DaryhenViancha/Agricultura-de-precision/Recursos/imagenes_wiki/pcb_elem1.jpeg

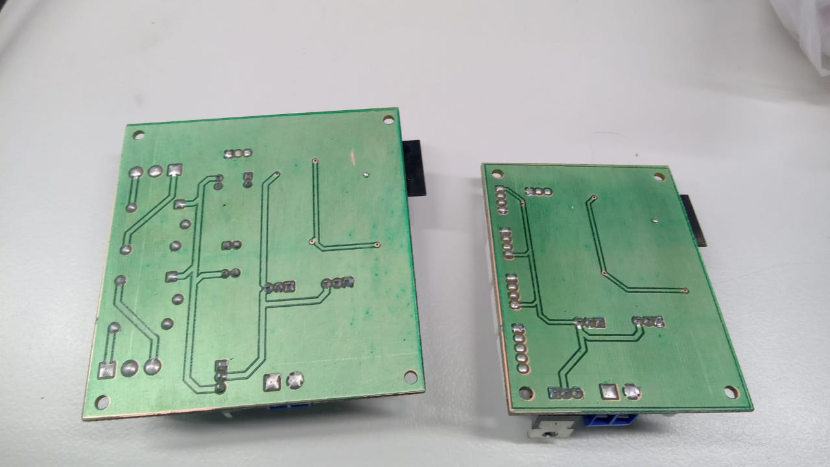
Recursos/imagenes_wiki/pcb_elem1.jpeg
