DaryhenViancha/Agricultura-de-precision/Recursos/imagenes_wiki/pcb_elem3.jpeg

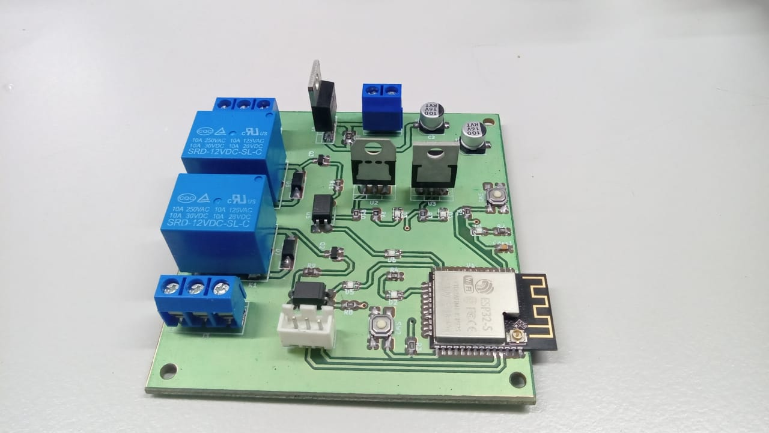
Recursos/imagenes_wiki/pcb_elem3.jpeg
