DaryhenViancha/Agricultura-de-precision/README.md

# Control de Biosistemas
Proyecto de Sistemas Embebidos 2021-2.    
Para la documentación del proyecto revisar la wiki.
