DaryhenViancha/Agricultura-de-precision/Diseño PCB/baterias/tp4056/report.txt

Info: Backing up file "C:\Users\mcsl1\OneDrive - Universidad Nacional de Colombia\Documentos\Universidad\Semestre 11\Embebidos\Control-de-biosistemas\Diseño PCB\baterias\tp4056\sym-lib-table" to file "C:\Users\mcsl1\OneDrive - Universidad Nacional de Colombia\Documentos\Universidad\Semestre 11\Embebidos\Control-de-biosistemas\Diseño PCB\baterias\tp4056\rescue-backup\sym-lib-table-2021-12-15-21-19-03".
Info: Backing up file "C:\Users\mcsl1\OneDrive - Universidad Nacional de Colombia\Documentos\Universidad\Semestre 11\Embebidos\Control-de-biosistemas\Diseño PCB\baterias\tp4056\charger_stepup.sch" to file "C:\Users\mcsl1\OneDrive - Universidad Nacional de Colombia\Documentos\Universidad\Semestre 11\Embebidos\Control-de-biosistemas\Diseño PCB\baterias\tp4056\rescue-backup\charger_stepup-2021-12-15-21-19-03.sch".
Info: Backing up file "C:\Users\mcsl1\OneDrive - Universidad Nacional de Colombia\Documentos\Universidad\Semestre 11\Embebidos\Control-de-biosistemas\Diseño PCB\baterias\tp4056\charger_stepup.pro" to file "C:\Users\mcsl1\OneDrive - Universidad Nacional de Colombia\Documentos\Universidad\Semestre 11\Embebidos\Control-de-biosistemas\Diseño PCB\baterias\tp4056\rescue-backup\charger_stepup-2021-12-15-21-19-03.pro".
Info: Backing up file "C:\Users\mcsl1\OneDrive - Universidad Nacional de Colombia\Documentos\Universidad\Semestre 11\Embebidos\Control-de-biosistemas\Diseño PCB\baterias\tp4056\charger_stepup-cache.lib" to file "C:\Users\mcsl1\OneDrive - Universidad Nacional de Colombia\Documentos\Universidad\Semestre 11\Embebidos\Control-de-biosistemas\Diseño PCB\baterias\tp4056\rescue-backup\charger_stepup-cache-2021-12-15-21-19-03.lib".
Info: Backing up file "C:\Users\mcsl1\OneDrive - Universidad Nacional de Colombia\Documentos\Universidad\Semestre 11\Embebidos\Control-de-biosistemas\Diseño PCB\baterias\tp4056\charger_stepup-rescue.lib" to file "C:\Users\mcsl1\OneDrive - Universidad Nacional de Colombia\Documentos\Universidad\Semestre 11\Embebidos\Control-de-biosistemas\Diseño PCB\baterias\tp4056\rescue-backup\charger_stepup-rescue-2021-12-15-21-19-03.lib".
Info: Backing up file "C:\Users\mcsl1\OneDrive - Universidad Nacional de Colombia\Documentos\Universidad\Semestre 11\Embebidos\Control-de-biosistemas\Diseño PCB\baterias\tp4056\charger_stepup-rescue.dcm" to file "C:\Users\mcsl1\OneDrive - Universidad Nacional de Colombia\Documentos\Universidad\Semestre 11\Embebidos\Control-de-biosistemas\Diseño PCB\baterias\tp4056\rescue-backup\charger_stepup-rescue-2021-12-15-21-19-03.dcm".
Info: Adding library "charger_stepup-rescue", file "${KIPRJMOD}/charger_stepup-rescue.lib" to project symbol library table.
Symbol "R" mapped to symbol library "charger_stepup-rescue".
Symbol "C" mapped to symbol library "charger_stepup-rescue".
Symbol "LED" mapped to symbol library "charger_stepup-rescue".
Symbol "R" mapped to symbol library "charger_stepup-rescue".
Symbol "LED" mapped to symbol library "charger_stepup-rescue".
Symbol "R" mapped to symbol library "charger_stepup-rescue".
Symbol "R" mapped to symbol library "charger_stepup-rescue".
Symbol "C" mapped to symbol library "charger_stepup-rescue".
Symbol "R" mapped to symbol library "charger_stepup-rescue".
Symbol "DW01" mapped to symbol library "charger_stepup-rescue".
Symbol "TP4056" mapped to symbol library "charger_stepup-rescue".
Symbol "CONN_01X01" mapped to symbol library "charger_stepup-rescue".
Symbol "CONN_01X01" mapped to symbol library "charger_stepup-rescue".
Symbol "CONN_01X01" mapped to symbol library "charger_stepup-rescue".
Symbol "CONN_01X01" mapped to symbol library "charger_stepup-rescue".
Symbol "CONN_01X01" mapped to symbol library "charger_stepup-rescue".
Symbol "CONN_01X01" mapped to symbol library "charger_stepup-rescue".
Symbol "C" mapped to symbol library "charger_stepup-rescue".
Symbol "FS8205A" mapped to symbol library "charger_stepup-rescue".
Info: Symbol library table mapping complete!
