DaryhenViancha/Agricultura-de-precision/diagramas/agricultura_precision.png

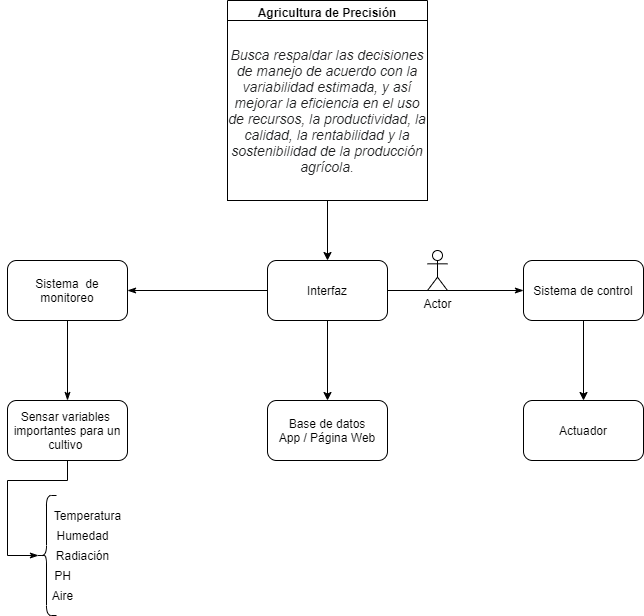
diagramas/agricultura_precision.png
