DaryhenViancha/Agricultura-de-precision/diagramas/arquitectura_biosistemas.drawio.png

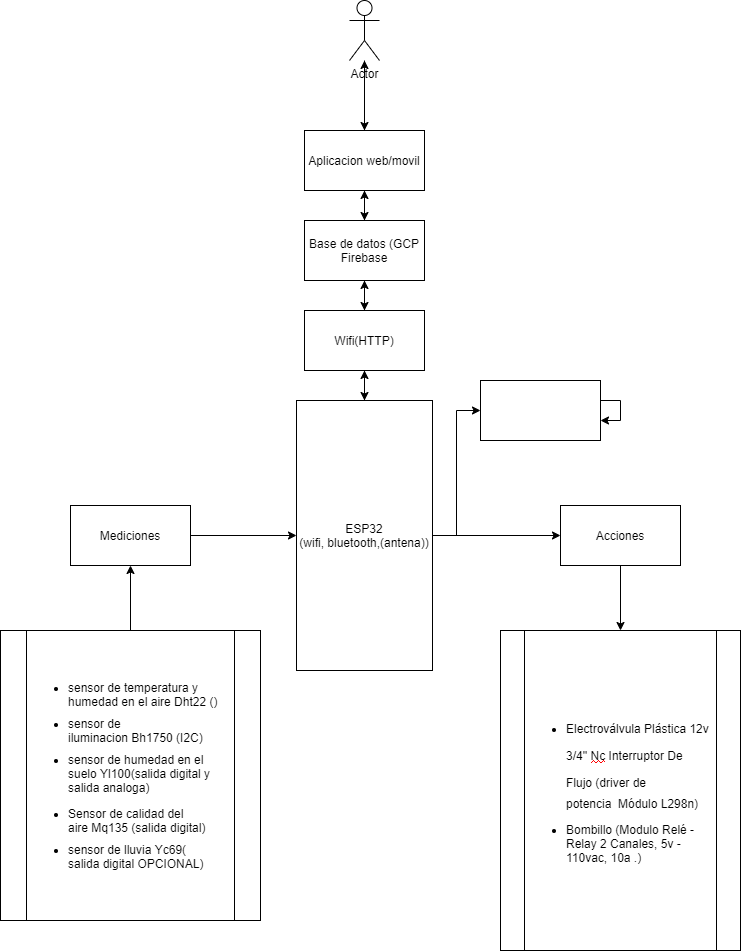
diagramas/arquitectura_biosistemas.drawio.png
