DaryhenViancha/Agricultura-de-precision/diagramas/flujo_proceso_datos.png

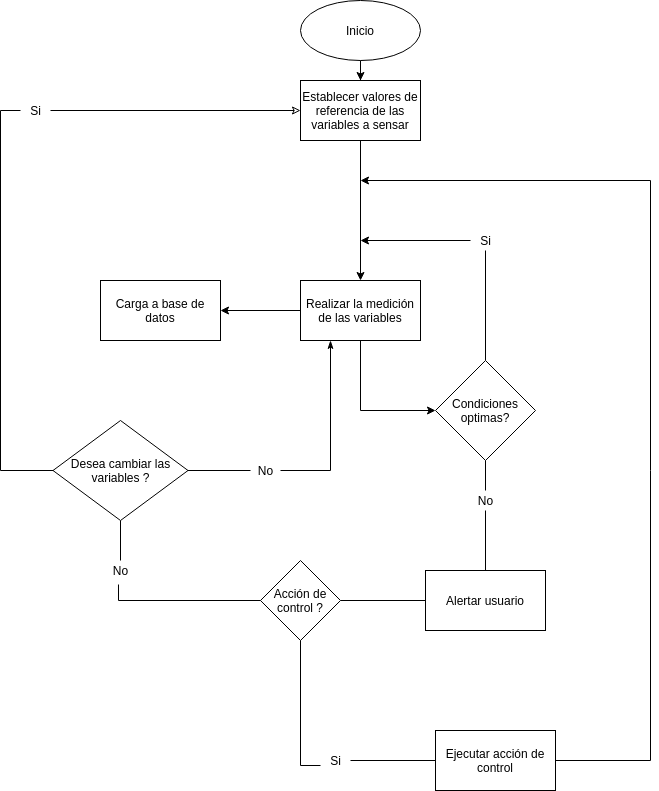
diagramas/flujo_proceso_datos.png
