DaryhenViancha/Agricultura-de-precision/diagramas/flujo_proceso_general.png

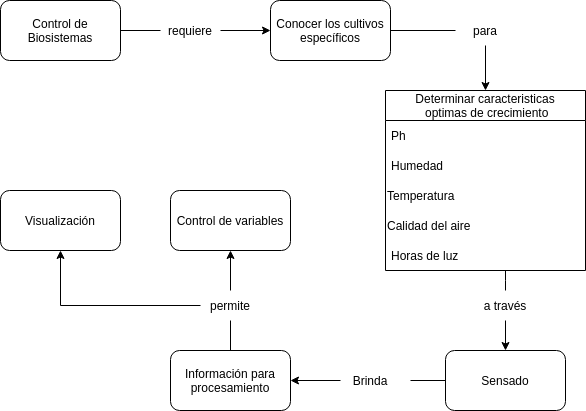
diagramas/flujo_proceso_general.png
