DaryhenViancha/Agricultura-de-precision/diagramas/mockup.png

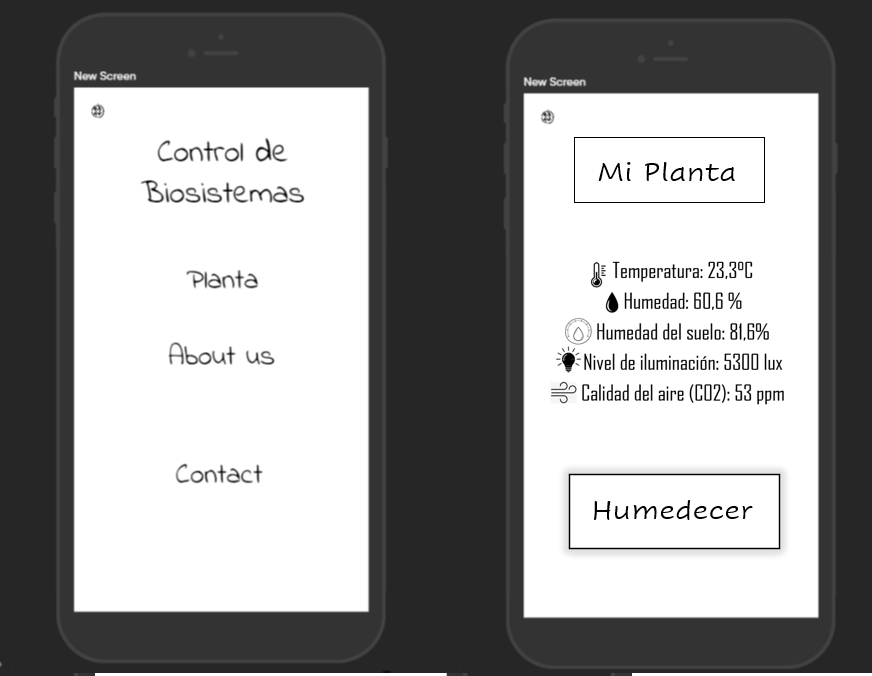
diagramas/mockup.png
