DaryhenViancha/Agricultura-de-precision/Recursos/gitpush.png

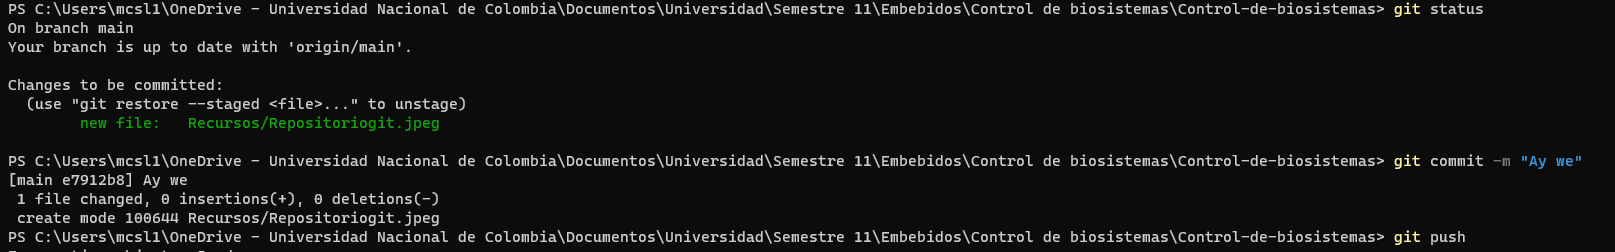
Recursos/gitpush.png
