DaryhenViancha/Agricultura-de-precision/Recursos/imagenes_wiki/esq_gnral.png

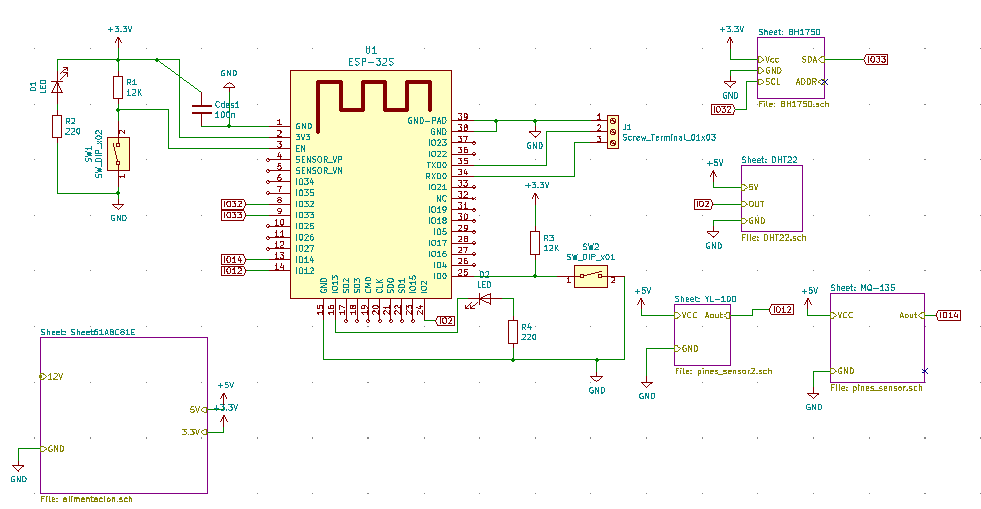
Recursos/imagenes_wiki/esq_gnral.png
