DaryhenViancha/Agricultura-de-precision/Recursos/imagenes_wiki/esq_gnral_reles.png

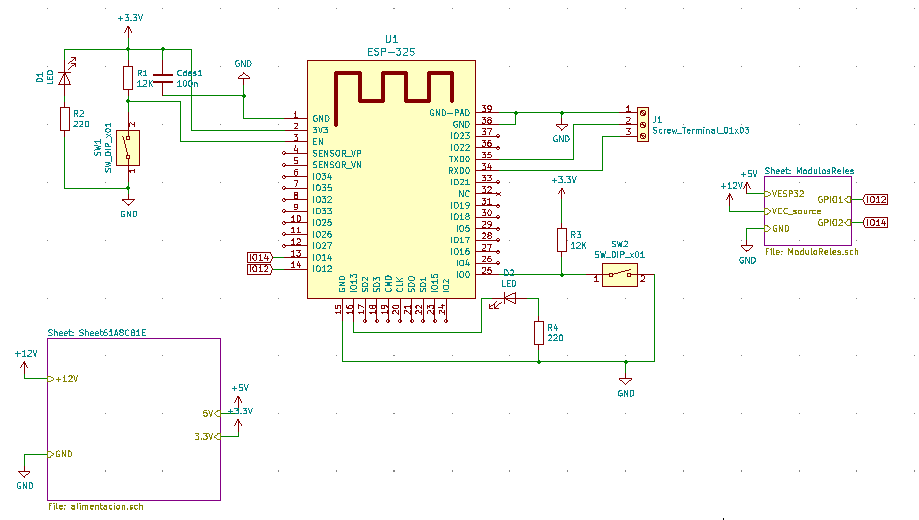
Recursos/imagenes_wiki/esq_gnral_reles.png
