DaryhenViancha/Agricultura-de-precision/Recursos/imagenes_wiki/pcb-elab1.jpeg

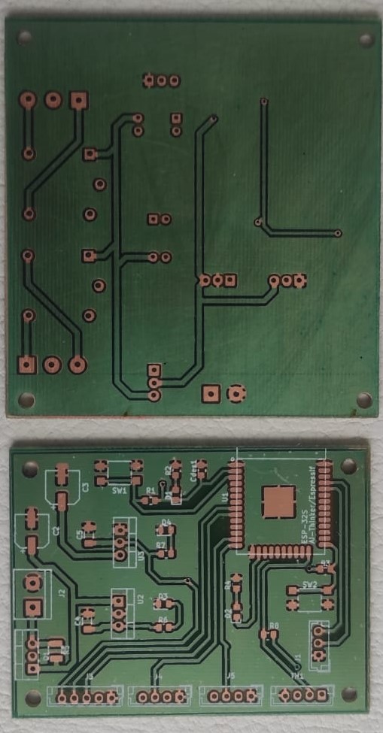
Recursos/imagenes_wiki/pcb-elab1.jpeg
