DaryhenViancha/Agricultura-de-precision/Recursos/imagenes_wiki/pcb-elab2.jpeg

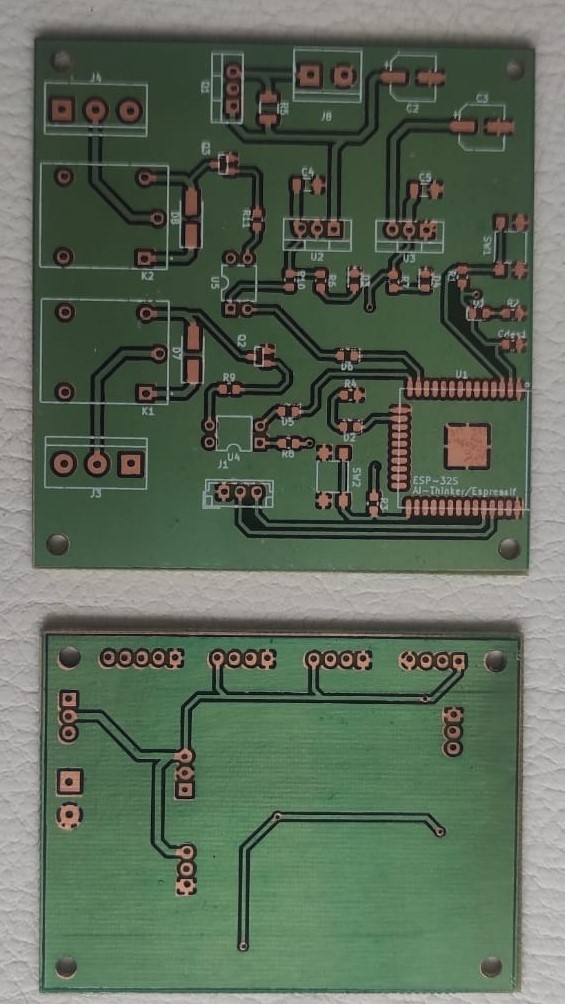
Recursos/imagenes_wiki/pcb-elab2.jpeg
