DaryhenViancha/Agricultura-de-precision/Recursos/imagenes_wiki/PCB-ESP32S.png

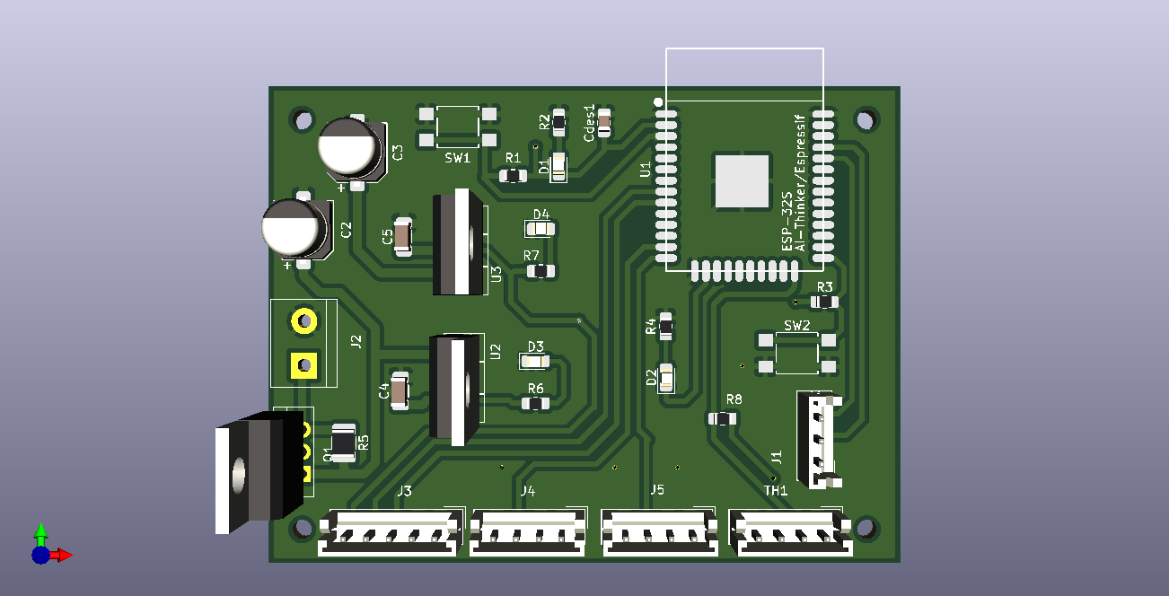
Recursos/imagenes_wiki/PCB-ESP32S.png
