DaryhenViancha/Agricultura-de-precision/Recursos/imagenes_wiki/PCB-ESP32S_2.png

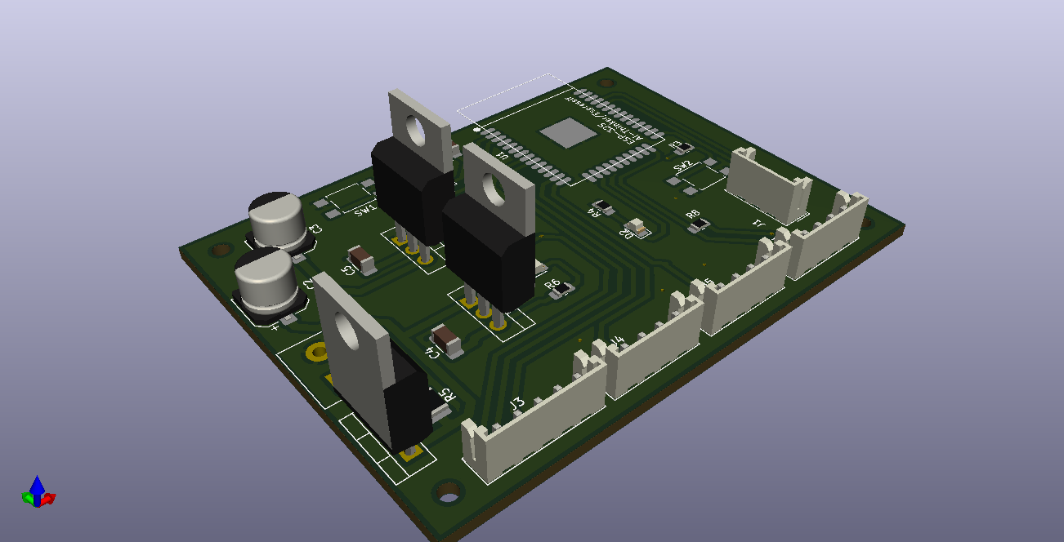
Recursos/imagenes_wiki/PCB-ESP32S_2.png
