DaryhenViancha/Agricultura-de-precision/Recursos/imagenes_wiki/PCB-ESP32S_reles.png

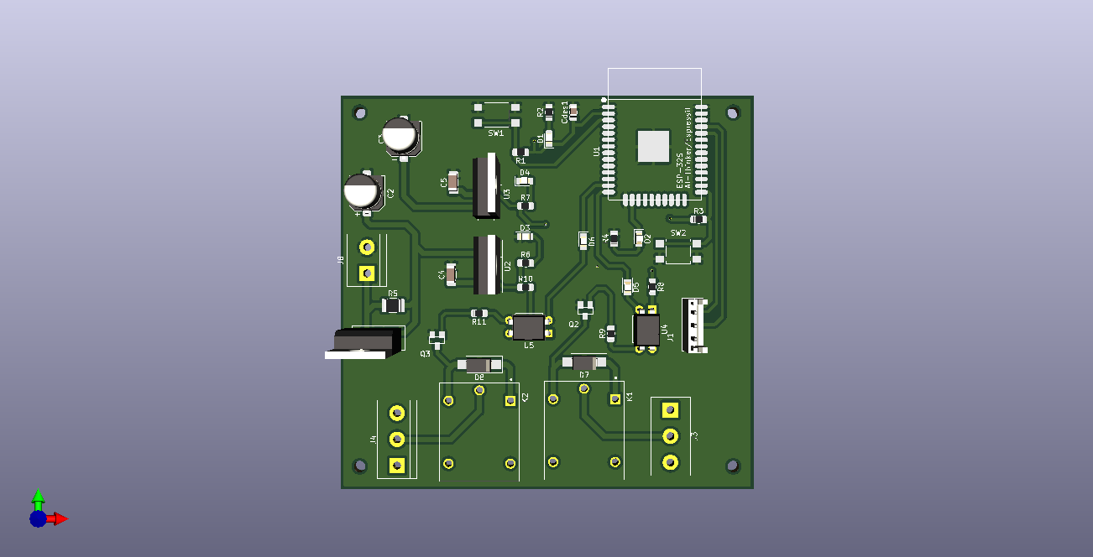
Recursos/imagenes_wiki/PCB-ESP32S_reles.png
