DaryhenViancha/Agricultura-de-precision/Recursos/imagenes_wiki/pcb_elem2.jpeg

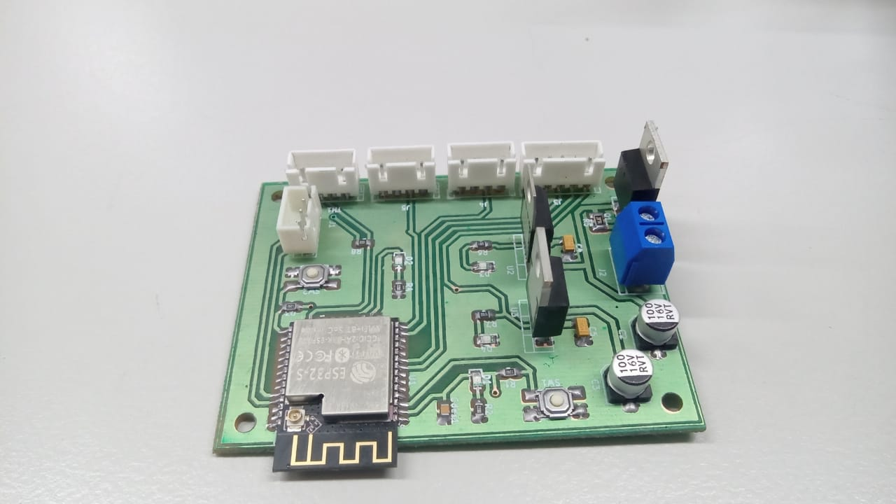
Recursos/imagenes_wiki/pcb_elem2.jpeg
