DaryhenViancha/Agricultura-de-precision/Recursos/Repositoriogit.jpeg

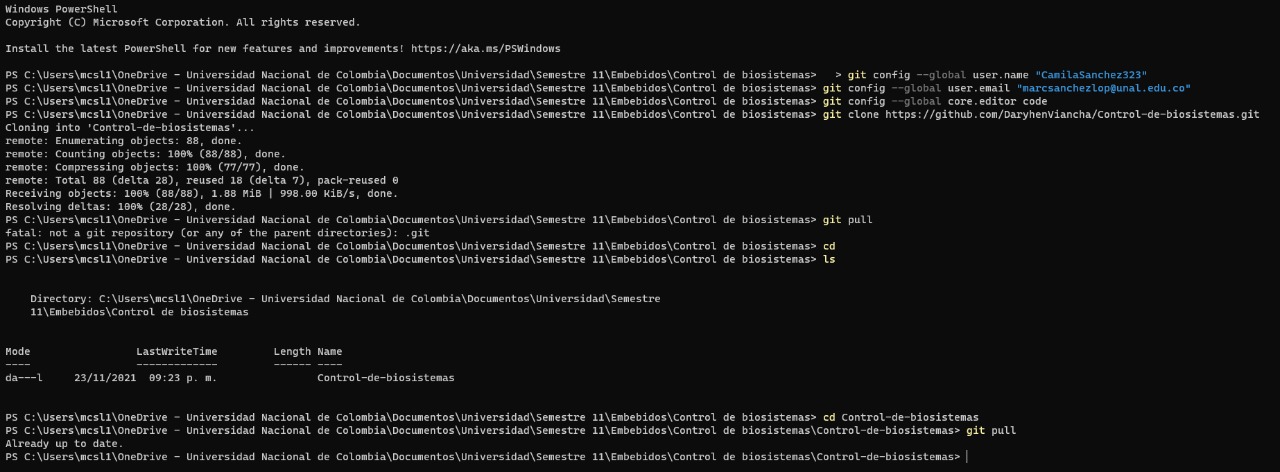
Recursos/Repositoriogit.jpeg
