DaryhenViancha/Agricultura-de-precision/Simulaciones/Etapa_Potencia/Imagenes/Etapa_pot.jpeg

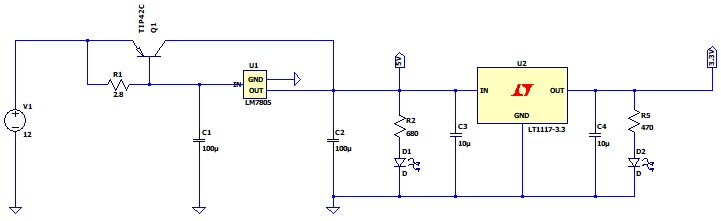
Simulaciones/Etapa_Potencia/Imagenes/Etapa_pot.jpeg
