DaryhenViancha/Agricultura-de-precision/Simulaciones/Etapa_Potencia/Imagenes/Etapa_pot_baja_impedancia_2.jpeg

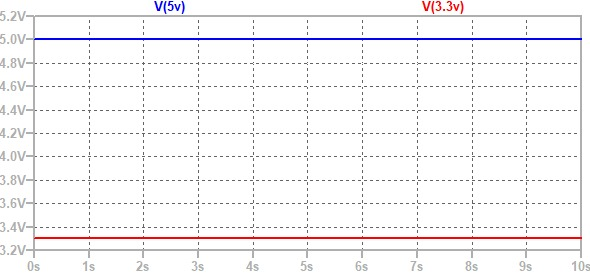
Simulaciones/Etapa_Potencia/Imagenes/Etapa_pot_baja_impedancia_2.jpeg
