DaryhenViancha/Agricultura-de-precision/Simulaciones/Etapa_Potencia/Imagenes/Etapa_pot_baja_impedancia_med.jpeg

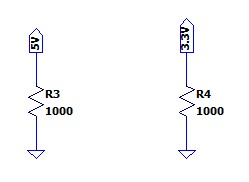
Simulaciones/Etapa_Potencia/Imagenes/Etapa_pot_baja_impedancia_med.jpeg
