DaryhenViancha/Agricultura-de-precision/Simulaciones/Etapa_Potencia/Imagenes/Etapa_pot_Vacio.jpeg

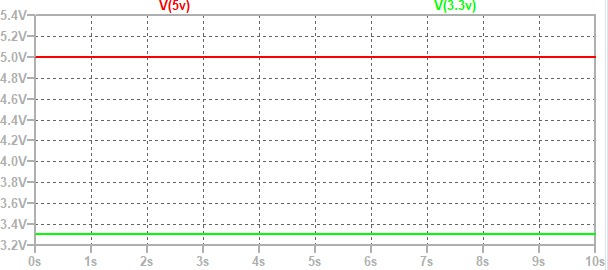
Simulaciones/Etapa_Potencia/Imagenes/Etapa_pot_Vacio.jpeg
