DaryhenViancha/Agricultura-de-precision/Recursos/imagenes_wiki/prueba_prog.jpeg

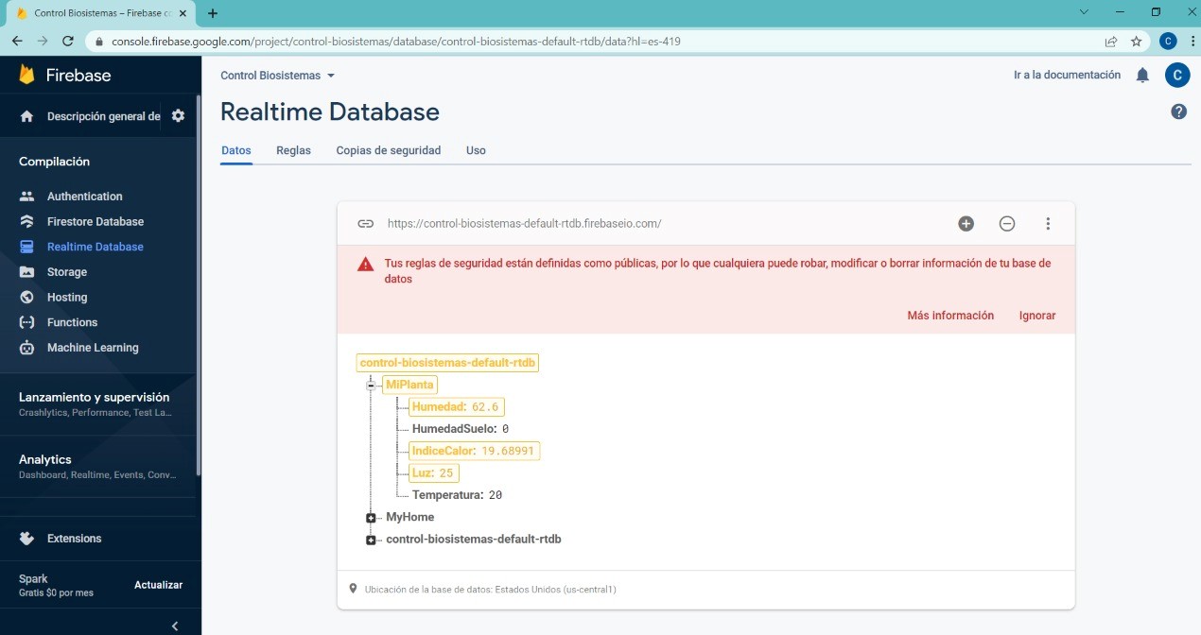
Recursos/imagenes_wiki/prueba_prog.jpeg
