DaryhenViancha/Agricultura-de-precision/Diseño PCB/PCB-ESP32S - reles/PCB-ESP32S.kicad_pcb

## KiCad design Diseño PCB/PCB-ESP32S - reles/PCB-ESP32S.kicad_pcb (2022-01-20)

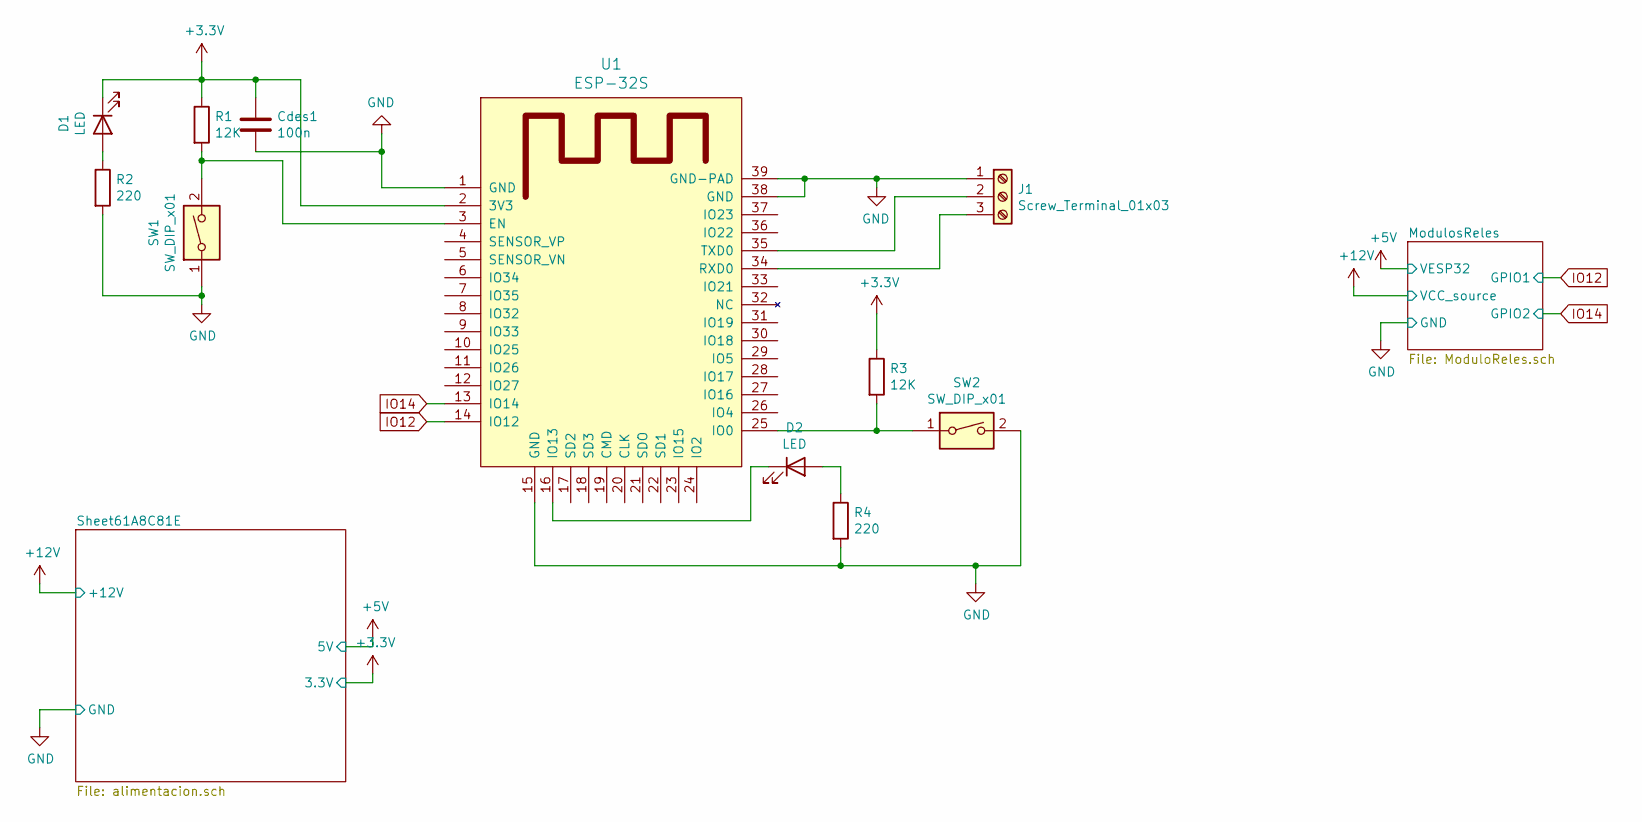
[picture p25: schematic PCB-ESP32S.sch]

Parts:
Cdes1: 100n; C_0805_2012Metric_Pad1.18x1.45mm_HandSolder
D1, D2: LED; LED_0805_2012Metric_Pad1.15x1.40mm_HandSolder
J1: Screw_Terminal_01x03; JST_EH_B3B-EH-A_1x03_P2.50mm_Vertical
R1, R3: 12K; R_0805_2012Metric_Pad1.20x1.40mm_HandSolder
R2, R4: 220; R_0805_2012Metric_Pad1.20x1.40mm_HandSolder
SW1, SW2: SW_DIP_x01; SW_SPST_TL3305A
U1: ESP-32S

Connections:
+3V3: Cdes1.1, D1.1 (K), R1.1, R3.1, U1.2 (3V3); also elsewhere on the board
GND: Cdes1.2, J1.1, R2.2, R4.2, SW1.1, SW2.2, U1.1 (GND), U1.15 (GND), U1.38 (GND), U1.39 (GND-PAD); also elsewhere on the board
IO12: U1.14 (IO12); also elsewhere on the board
IO14: U1.13 (IO14); also elsewhere on the board
unnamed: D1.2 (A), R2.1
unnamed: D2.1 (K), U1.16 (IO13)
unnamed: D2.2 (A), R4.1
unnamed: J1.2, U1.35 (TXD0)
unnamed: J1.3, U1.34 (RXD0)
unnamed: R1.2, SW1.2, U1.3 (EN)
unnamed: R3.2, SW2.1, U1.25 (IO0)

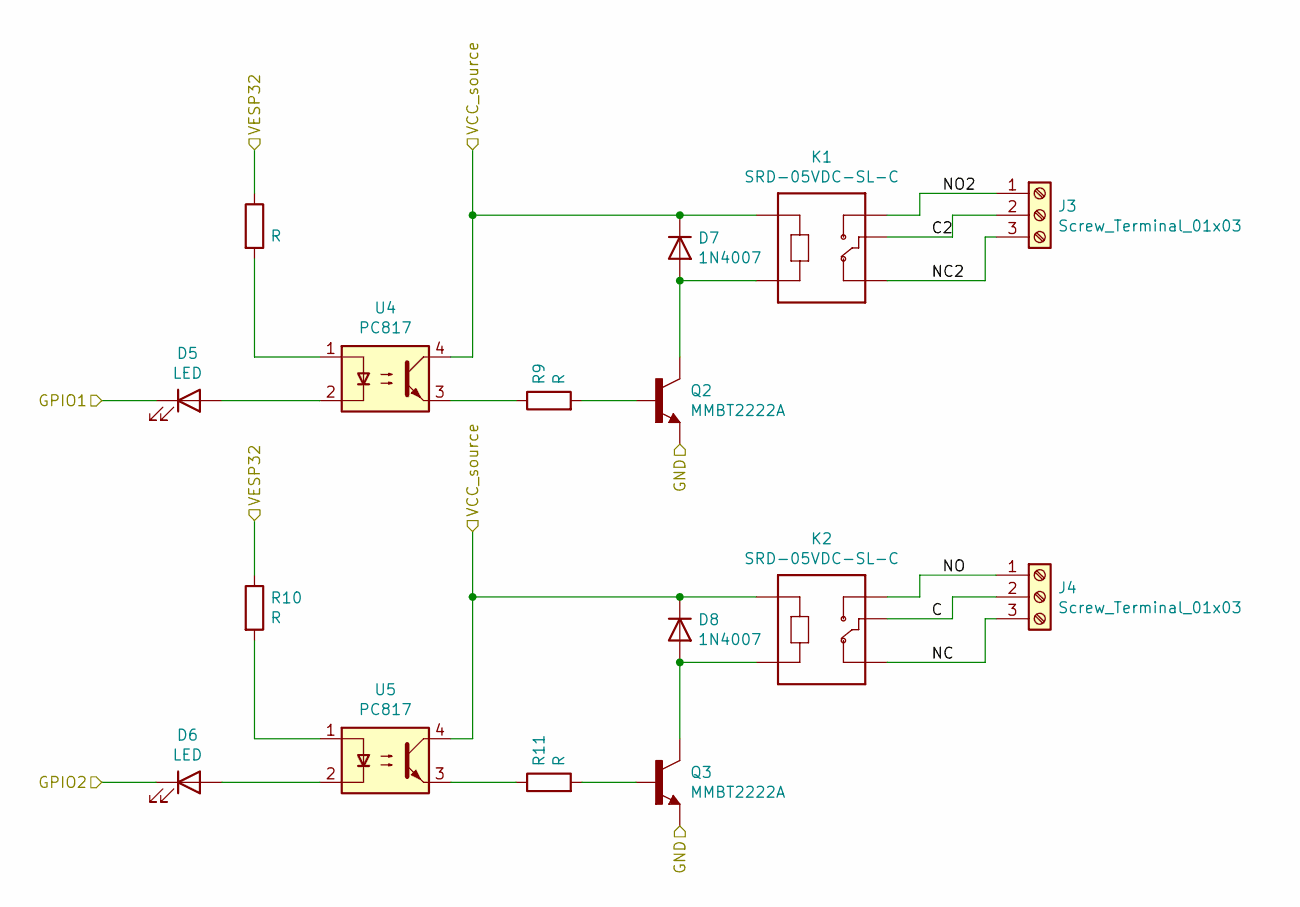
[picture p26: schematic ModuloReles.sch]

Parts:
D5, D6: LED; LED_0805_2012Metric_Pad1.15x1.40mm_HandSolder
D7, D8: 1N4007; D_SMA_Handsoldering
J3, J4: Screw_Terminal_01x03; TerminalBlock_bornier-3_P5.08mm
K1, K2: SRD-05VDC-SL-C; RELAY_SRD-05VDC-SL-C
Q2, Q3: MMBT2222A; SOT23; DIGIKEY 568-4509-6-ND
R8, R9, R10, R11: R; R_0805_2012Metric_Pad1.20x1.40mm_HandSolder
U4, U5: PC817; DIP-4_W7.62mm

Connections:
+5V: R8.1, R10.1; also elsewhere on the board
+12V: D7.1 (K), D8.1 (K), K1.A1, K2.A1, U4.4, U5.4; also elsewhere on the board
/ModulosReles/C: J4.2, K2.COM
/ModulosReles/C2: J3.2, K1.COM
/ModulosReles/NC: J4.3, K2.NC
/ModulosReles/NC2: J3.3, K1.NC
/ModulosReles/NO: J4.1, K2.NO
/ModulosReles/NO2: J3.1, K1.NO
GND: Q2.2, Q3.2; also elsewhere on the board
IO12: D5.1 (K); also elsewhere on the board
IO14: D6.1 (K); also elsewhere on the board
unnamed: D5.2 (A), U4.2
unnamed: D6.2 (A), U5.2
unnamed: D7.2 (A), K1.A2, Q2.3
unnamed: D8.2 (A), K2.A2, Q3.3
unnamed: Q2.1, R9.2
unnamed: Q3.1, R11.2
unnamed: R8.2, U4.1
unnamed: R9.1, U4.3
unnamed: R10.2, U5.1
unnamed: R11.1, U5.3

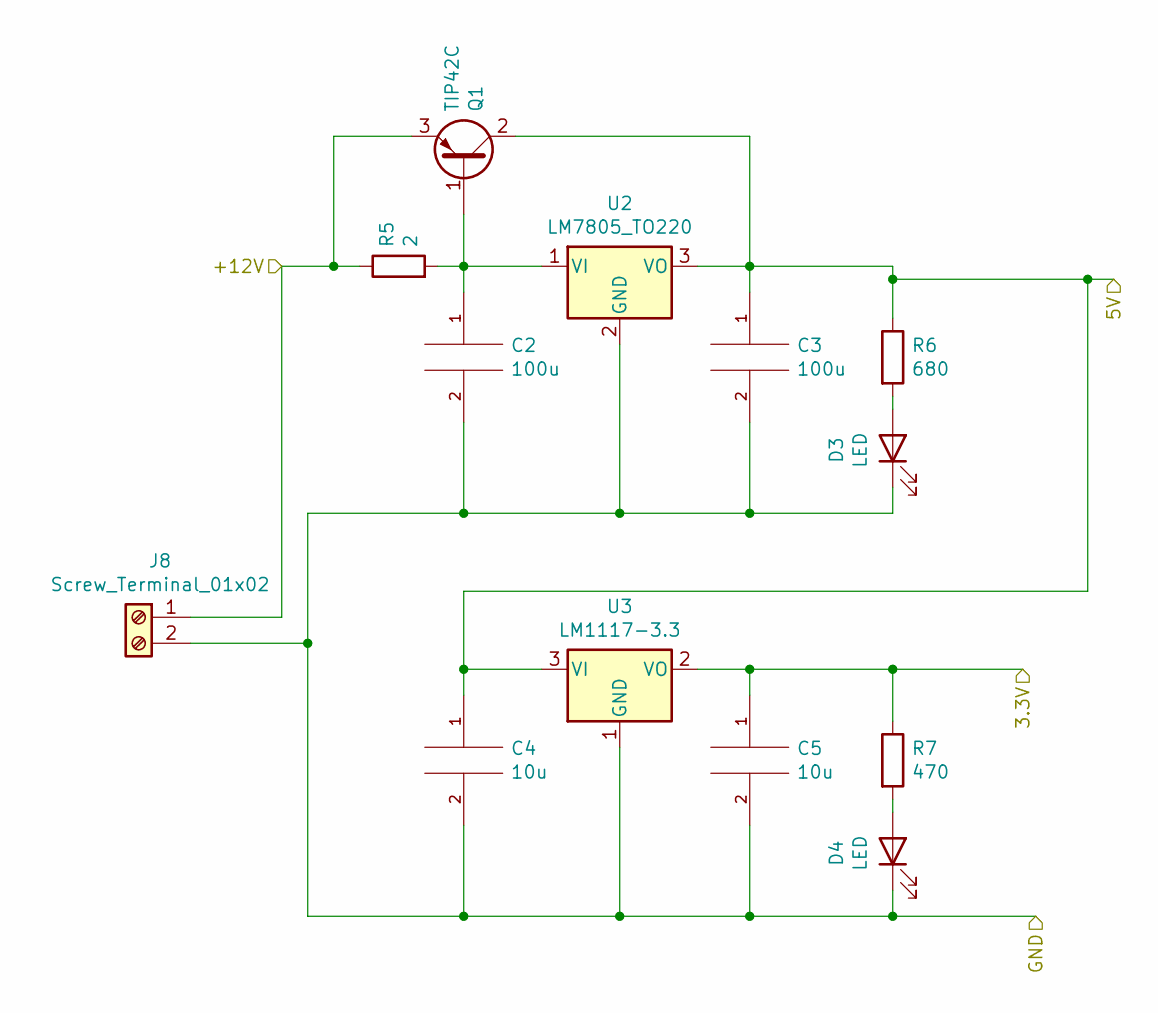
[picture p27: schematic alimentacion.sch]

Parts:
C2, C3: 100u; CP_Elec_6.3x5.8
C4, C5: 10u; C_1206_3216Metric_Pad1.33x1.80mm_HandSolder
D3, D4: LED; LED_0805_2012Metric_Pad1.15x1.40mm_HandSolder
J8: Screw_Terminal_01x02; TerminalBlock_bornier-2_P5.08mm
Q1: TIP42C; TO-220-3_Vertical
R5: 2; R_1210_3225Metric_Pad1.30x2.65mm_HandSolder
R6: 680; R_0805_2012Metric_Pad1.20x1.40mm_HandSolder
R7: 470; R_0805_2012Metric_Pad1.20x1.40mm_HandSolder
U2: LM7805_TO220; TO-220-3_Vertical
U3: LM1117-3.3; TO-220-3_Vertical

Connections:
+3V3: C5.1, R7.1, U3.2 (VO); also elsewhere on the board
+5V: C3.1, C4.1, Q1.2 (C), R6.1, U2.3 (VO), U3.3 (VI); also elsewhere on the board
+12V: J8.1, Q1.3 (E), R5.1; also elsewhere on the board
GND: C2.2, C3.2, C4.2, C5.2, D3.1 (K), D4.1 (K), J8.2, U2.2 (GND), U3.1 (GND); also elsewhere on the board
unnamed: C2.1, Q1.1 (B), R5.2, U2.1 (VI)
unnamed: D3.2 (A), R6.2
unnamed: D4.2 (A), R7.2

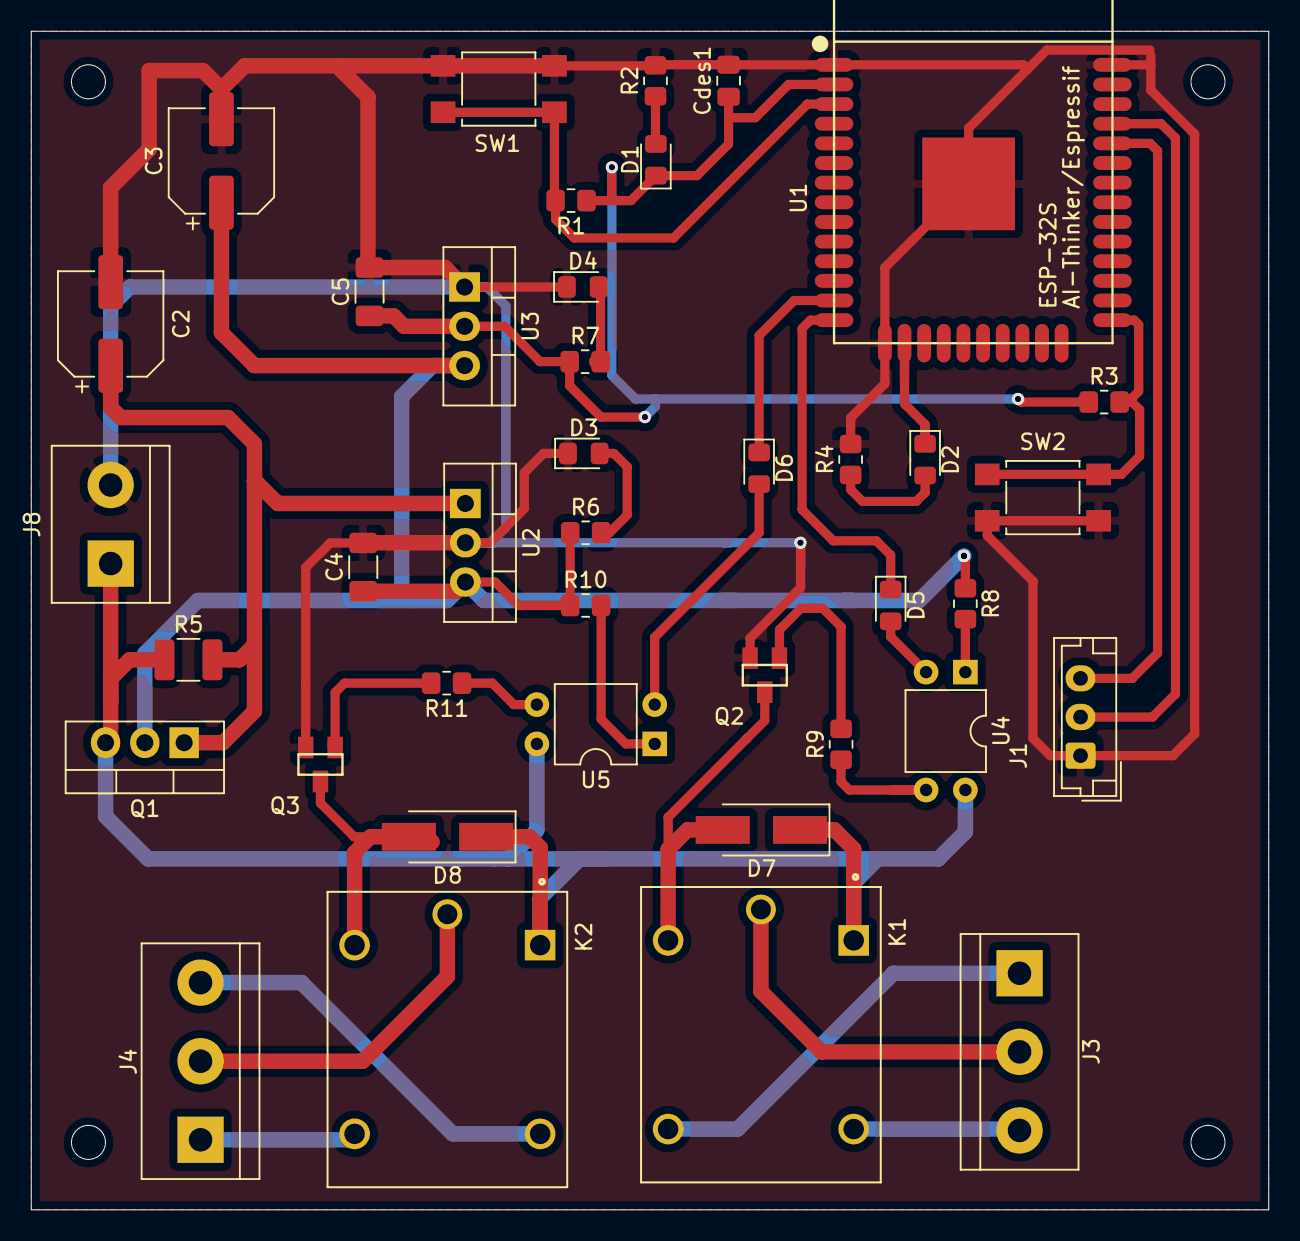
[picture p28: board Diseño PCB/PCB-ESP32S - reles/PCB-ESP32S.kicad_pcb from above]

Board: 2 copper layers, 80.0 x 76.2 mm, 40 parts (0 on the bottom side), 32 nets.
