DaryhenViancha/Agricultura-de-precision/Diseño PCB/PCB-ESP32S - Baterias-incompleto/PCB-ESP32S.kicad_pcb

## KiCad design Diseño PCB/PCB-ESP32S - Baterias-incompleto/PCB-ESP32S.kicad_pcb (2021-12-19)

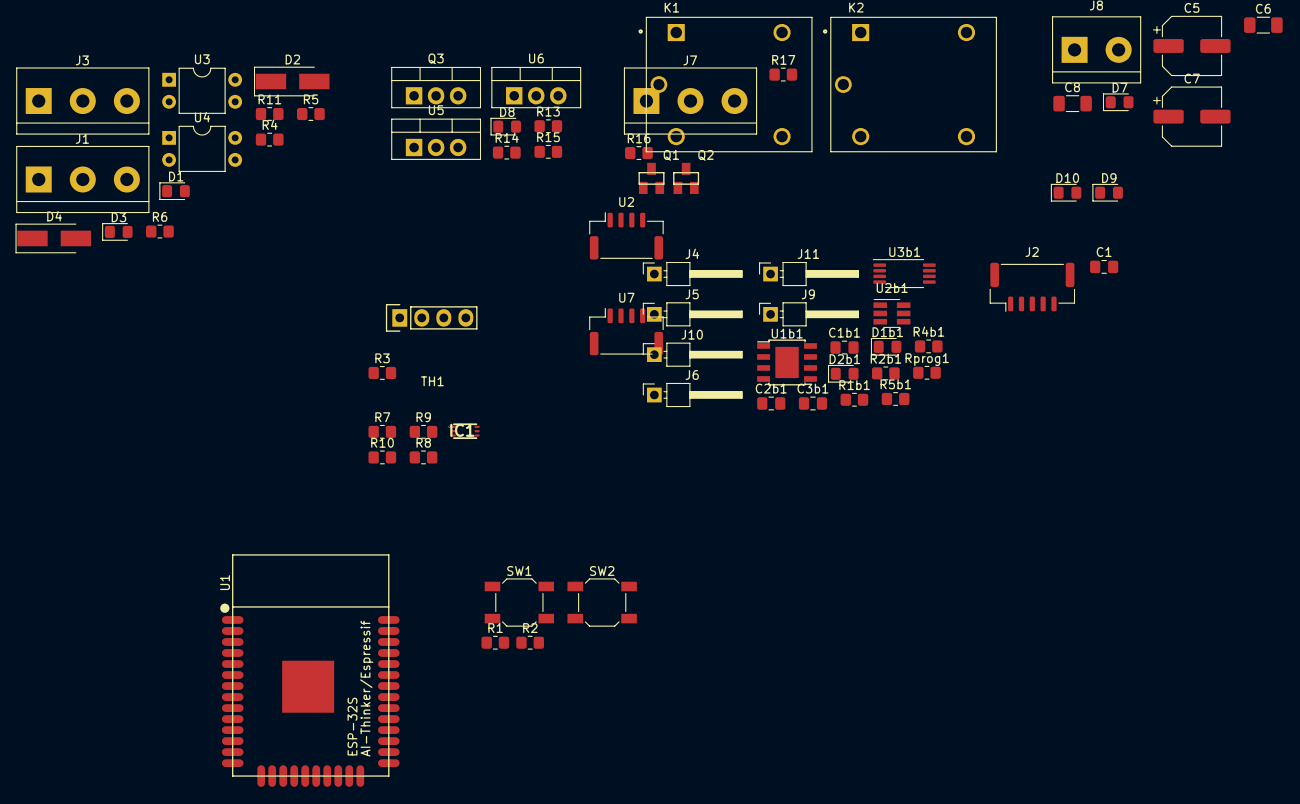
[picture p29: board Diseño PCB/PCB-ESP32S - Baterias-incompleto/PCB-ESP32S.kicad_pcb from above]

Board: 2 copper layers, 69 parts (0 on the bottom side), 50 nets, no tracks yet.

Parts:
C1, C1b1, C3b1: 0.1uF; C_0805_2012Metric_Pad1.18x1.45mm_HandSolder
C2b1: 10uF; C_0805_2012Metric_Pad1.18x1.45mm_HandSolder
C5, C7: 100u; CP_Elec_6.3x5.8
C6, C8: 10u; C_1206_3216Metric_Pad1.33x1.80mm_HandSolder
D1, D1b1, D2b1, D3, D7, D8, D9, D10: LED; LED_0805_2012Metric_Pad1.15x1.40mm_HandSolder
D2, D4: 1N4007; D_SMA_Handsoldering
IC1: BH1750FVI-TR; WSOF6
J1, J3, J7: Screw_Terminal_01x03; TerminalBlock_bornier-3_P5.08mm
J2: Screw_Terminal_01x05; JST_GH_BM05B-GHS-TBT_1x05-1MP_P1.25mm_Vertical
J4: CONN_bat+; PinHeader_1x01_P2.54mm_Horizontal
J5: CONN_bat-; PinHeader_1x01_P2.54mm_Horizontal
J6: CONN_out-; PinHeader_1x01_P2.54mm_Horizontal
J8: Screw_Terminal_01x02; TerminalBlock_bornier-2_P5.08mm
J9: CONN_out+; PinHeader_1x01_P2.54mm_Horizontal
J10: CONN_in+; PinHeader_1x01_P2.54mm_Horizontal
J11: CONN_in-; PinHeader_1x01_P2.54mm_Horizontal
K1, K2: SRD-05VDC-SL-C; RELAY_SRD-05VDC-SL-C
Q1, Q2: MMBT2222A; SOT23
Q3: TIP42C; TO-220-3_Vertical
R1, R2: 12K; R_0805_2012Metric_Pad1.20x1.40mm_HandSolder
R1b1, R2b1, R3, R4b1, R7: 1k; R_0805_2012Metric_Pad1.20x1.40mm_HandSolder
R4, R5, R6, R11: R; R_0805_2012Metric_Pad1.20x1.40mm_HandSolder
R5b1: 100; R_0805_2012Metric_Pad1.20x1.40mm_HandSolder
R8, R9, R10: 4.7k; R_0805_2012Metric_Pad1.20x1.40mm_HandSolder
R13: 2; R_0805_2012Metric_Pad1.20x1.40mm_HandSolder
R14: 680; R_0805_2012Metric_Pad1.20x1.40mm_HandSolder
R15: 470; R_0805_2012Metric_Pad1.20x1.40mm_HandSolder
R16, R17: 220; R_0805_2012Metric_Pad1.20x1.40mm_HandSolder
Rprog1: 10k; R_0805_2012Metric_Pad1.20x1.40mm_HandSolder
SW1, SW2: SW_DIP_x01; SW_SPST_SKQG_WithStem
TH1: DHT22_Temperature_Humidity
U1: ESP-32S
U1b1: TP4056; TP4056_SOP-8-PP
U2, U7: pines_sensor; JST_GH_SM04B-GHS-TB_1x04-1MP_P1.25mm_Horizontal
U2b1: DW01; SOT-23-6_Handsoldering
U3, U4: PC817; DIP-4_W7.62mm
U3b1: FS8205A; TSSOP-8_4.4x3mm_P0.65mm
U5: LM7805_TO220; TO-220-3_Vertical
U6: LM1117-3.3; TO-220-3_Vertical

Connections:
+3V3: D9.1, IC1.1, J2.1, R1.1, R2.1, R7.2, R9.1, R10.1, U1.2
+5V: R3.1, TH1.1
/BH1750/ADDR: IC1.2, J2.5, R8.1
/BH1750/SCL: IC1.6, J2.3, R10.2
/BH1750/SDA: IC1.4, J2.4, R9.2
/ModulosReles/C: J1.2, J3.2, K1.COM, K2.COM
/ModulosReles/GND: Q1.2, Q2.2
/ModulosReles/NC: J1.3, J3.3, K1.NC, K2.NC
/ModulosReles/NO: J1.1, J3.1, K1.NO, K2.NO
/ModulosReles/VCC_source: D2.1, D4.1, K1.A1, K2.A1, U3.4, U4.4
/Sheet61A8C81E/3.3V: C8.1, R15.1, U6.2
/Sheet61A8C81E/5V: C7.1, Q3.2, R14.1, U5.3
/Sheet61A8C81E/12v: C6.1, J8.1, Q3.3, R13.1, U6.3
/Sheet61A8C81E/GND: C5.2, C6.2, C7.2, C8.2, D7.1, D8.1, J8.2, U5.2, U6.1
/baterias/BAT+: C2b1.1, J4.1, J9.1, R5b1.2, U1b1.5
/baterias/BAT-: C3b1.2, J5.1, U2b1.6, U3b1.2, U3b1.3
/baterias/IN+: C1b1.1, D1b1.2, D2b1.2, J10.1, U1b1.4, U1b1.8, U1b1.9
/baterias/IN-: C1b1.2, C2b1.2, J11.1, R4b1.2, Rprog1.2, U1b1.1, U1b1.3, U3b1.6, U3b1.7
GND: C1.2, IC1.3, J2.2, J7.1, R8.2, R16.2, R17.2, SW1.1, SW2.2, TH1.4, U1.1, U1.15, U1.39
IO4: R3.2, TH1.2, U1.26
unnamed: C1.1, IC1.5, R7.1
unnamed: C3b1.1, R5b1.1, U2b1.5
unnamed: C5.1, Q3.1, R13.2, U5.1
unnamed: D1.2, U3.2
unnamed: D1b1.1, R1b1.1
unnamed: D2.2, K1.A2, Q1.3
unnamed: D2b1.1, R2b1.1
unnamed: D3.2, U4.2
unnamed: D4.2, K2.A2, Q2.3
unnamed: D7.2, R14.2
unnamed: D8.2, R15.2
unnamed: D9.2, R16.1
unnamed: D10.1, U1.16
unnamed: D10.2, R17.1
unnamed: J7.2, U1.35
unnamed: J7.3, U1.34
unnamed: Q1.1, R6.2
unnamed: Q2.1, R11.2
unnamed: R1.2, SW1.2, U1.3
unnamed: R1b1.2, U1b1.7
unnamed: R2.2, SW2.1, U1.25
unnamed: R2b1.2, U1b1.6
unnamed: R4.2, U4.1
unnamed: R4b1.1, U2b1.2
unnamed: R5.2, U3.1
unnamed: R6.1, U3.3
unnamed: R11.1, U4.3
unnamed: Rprog1.1, U1b1.2
unnamed: U2b1.1, U3b1.4
unnamed: U2b1.3, U3b1.5
