DaryhenViancha/Agricultura-de-precision/Diseño PCB/PCB-ESP32S - Baterias-incompleto/LIBRERIAS/Librerias_new/gasdetector/gasdetector.kicad_pcb

## KiCad design Diseño PCB/PCB-ESP32S - Baterias-incompleto/LIBRERIAS/Librerias_new/gasdetector/gasdetector.kicad_pcb (2021-11-25)

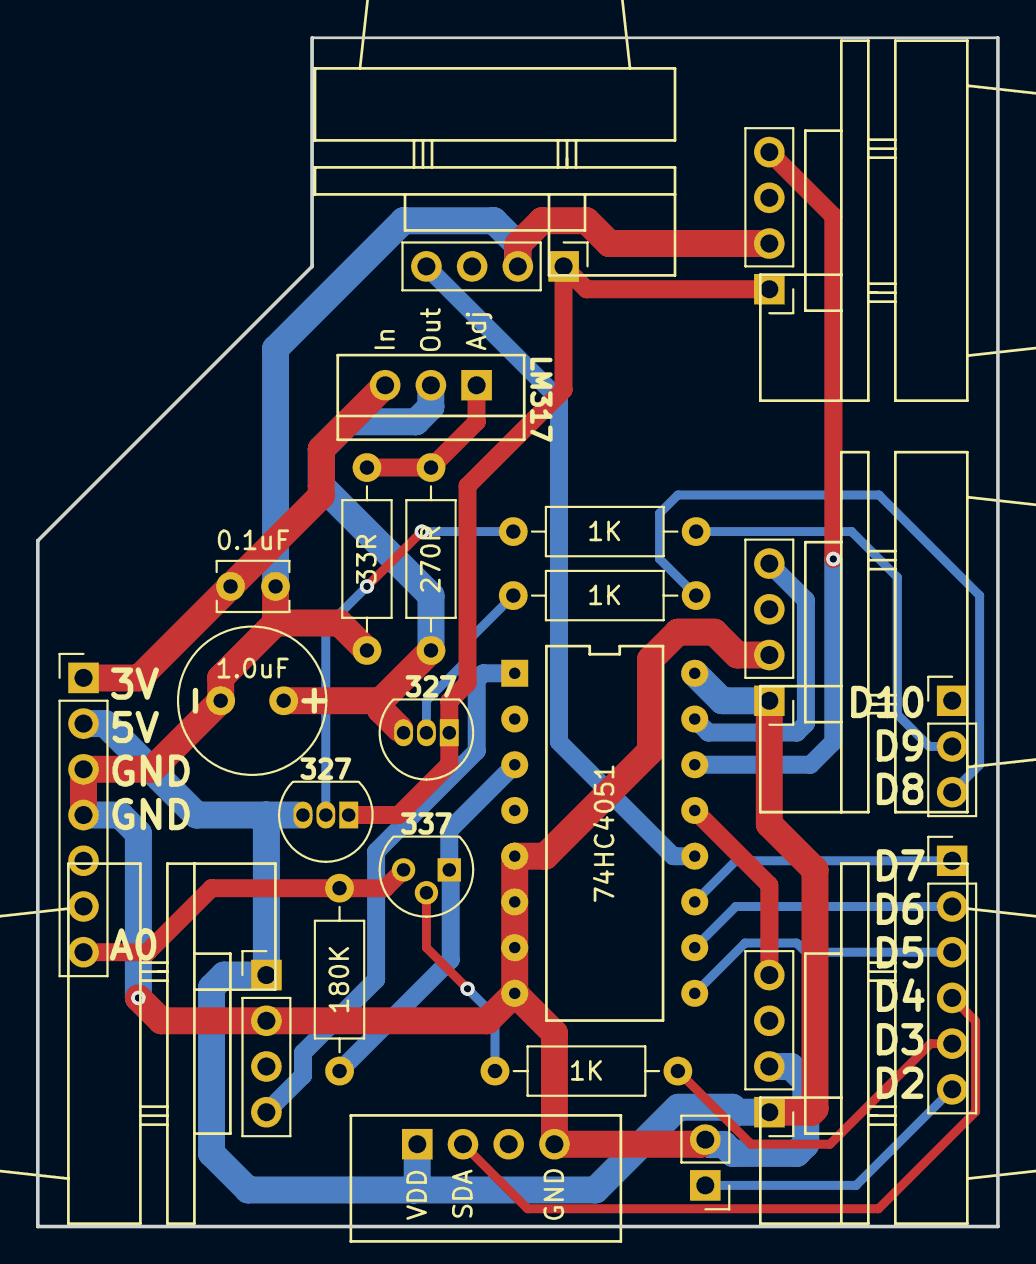
[picture p30: board gasdetector.kicad_pcb from above]

Board: 2 copper layers, 53.3 x 66.0 mm, 23 parts (0 on the bottom side), 24 nets.

Parts:
C1: 1.0uF; C_Radial_D8.0mm_H7.0mm_P3.50mm
C2: 0.1uF; C_Disc_D3.8mm_W2.6mm_P2.50mm
J1: Conn_01x07_Male; PinHeader_1x07_P2.54mm_Vertical
J2: SetupMode; PinHeader_1x02_P2.54mm_Vertical
J3: D8-D10; PinHeader_1x03_P2.54mm_Vertical
J4: D2-D7; PinHeader_1x06_P2.54mm_Vertical
Q1, Q3: BC327; TO-92_Inline
Q2: BC337; TO-92
R1, R5, R6: 1K; R_Axial_DIN0207_L6.3mm_D2.5mm_P10.16mm_Horizontal
R2, R3: R; R_Axial_DIN0207_L6.3mm_D2.5mm_P10.16mm_Horizontal
R4: 180K; R_Axial_DIN0207_L6.3mm_D2.5mm_P10.16mm_Horizontal
S1: MQ-2; MQ-x
S2: MQ-7; MQ-x
S3: MQ-8; MQ-x
S4: MQ-9; MQ-x
S5: MQ-135; MQ-x
U1: 74HC4051; 74HC4051N
U2: DHT11; AM2302
U3: LM317_3PinPackage; LM317

Connections:
+3V3: C2.2, J1.1, U3.3
+5V: J1.2, Q3.3, S1.1, S3.1, S5.1, U1.16, U2.1
GND: C1.1, C2.1, J1.3, J1.4, J2.2, R3.1, S1.2, S2.2, S3.2, S4.2, S5.2, U1.5, U1.6, U1.7, U1.8, U2.4
unnamed: C1.2, Q1.3, R2.2, U3.2
unnamed: J1.7, Q2.3, R4.2
unnamed: J2.1, J4.6
unnamed: J3.2, R6.2
unnamed: J3.3, R1.2
unnamed: J4.1, U1.11
unnamed: J4.2, U1.10
unnamed: J4.3, U1.9
unnamed: J4.4, U2.2
unnamed: J4.5, R5.1
unnamed: Q1.1, Q3.1, S2.1, S4.1
unnamed: Q1.2, R1.1
unnamed: Q2.1, R4.1, U1.3
unnamed: Q2.2, R5.2
unnamed: Q3.2, R6.1
unnamed: R2.1, R3.2, U3.1
unnamed: S1.4, U1.13
unnamed: S2.4, U1.14
unnamed: S3.4, U1.15
unnamed: S4.4, U1.12
unnamed: S5.4, U1.1
