DaryhenViancha/Agricultura-de-precision/Diseño PCB/baterias/tp4056/rescue-backup/charger_stepup-2021-12-15-20-48-13.sch

## KiCad design Diseño PCB/baterias/tp4056/rescue-backup/charger_stepup-2021-12-15-20-48-13.sch (2021-12-16)

Schematic: charger_stepup-2021-12-15-20-48-13.sch

Parts:
C1, C2: 0.1uF; C_0805_HandSoldering
C3: 10uF; C_0805_HandSoldering
D1, D2: LED; LED_0603_HandSoldering
J1: CONN_in-; Pin_Header_Straight_1x01_Pitch2.54mm
J2: CONN_in+; Pin_Header_Straight_1x01_Pitch2.54mm
J3: conOut+; Pin_Header_Straight_1x01_Pitch2.54mm
J4: conOut-; Pin_Header_Straight_1x01_Pitch2.54mm
J5: CONN_bat+; Pin_Header_Straight_1x01_Pitch2.54mm
J6: CONN_bat-; Pin_Header_Straight_1x01_Pitch2.54mm
R1, R2, R4: 1k; R_0603_HandSoldering
R3: 10k; R_0603_HandSoldering
R5: 100; R_0603_HandSoldering
U1: TP4056; TP4056_SOP-8-PP
U2: DW01; SOT-23-6_Handsoldering
U3: FS8205A; TSSOP-8_4.4x3mm_Pitch0.65mm

Notes on the sheet:
Set Charging Current to 130ma
ceramic cap
