DaryhenViancha/Agricultura-de-precision/Programación/YL-100.ino

int sensorPin = 12;
void setup() {
  // put your setup code here, to run once:
  Serial.begin(9600);

}

void loop() {
  // put your main code here, to run repeatedly:
  int humedad = analogRead(sensorPin);
  Serial.println(humedad);
  delay(500);

}
