DaryhenViancha/Agricultura-de-precision/(commit log)

2021-11-04 Datasheet ESP32-s
2021-11-24 Hojas de datos
2021-11-25 agregando esp32 y pcb v1
    [PCB-ESP32S.kicad_pcb, PCB-ESP32S.sch, file61A137FD.sch]
2021-11-25 Relé control de motores
2021-11-25 variables globales
    [file61A137FD.sch, gasdetector.kicad_pcb, gasdetector.sch]
2021-11-25 agregando esp32s
    [ESP32-Footprints.kicad_pcb, ESP32-Footprints.sch, espressif-xess.csv]
2021-11-25 actualizando dibujo
    [PCB-ESP32S.kicad_pcb, PCB-ESP32S.sch, file61A137FD.sch]
2021-11-25 beta sensores yl100 & mq135
    [PCB-ESP32S.sch, file61A137FD.sch, pines_sensor.sch]
2021-11-30 Modulo Relé
    [ModuloReles.sch, PCB-ESP32S.sch, file61A137FD.sch]
2021-12-02 Actualización modulo Relé
    [PCB-ESP32S.sch]
2021-12-02 Humedad y luz
    [BH1750.sch, DHT22.sch, ModuloReles.sch, PCB-ESP32S.sch, pines_sensor.sch]
2021-12-02 actualizacion alimentacion
    [12volts.sch, BH1750.sch, DHT22.sch, ModuloReles.sch, PCB-ESP32S.sch, alimentacion.sch, pines_sensor.sch]
2021-12-02 Actualización Relé
    [ModuloReles.sch, PCB-ESP32S.sch, alimentacion.sch]
2021-12-02 Actualización footprints
    [ModuloReles.sch]
2021-12-02 footprint sensores mq135 y yl100
    [pines_sensor.sch]
2021-12-02 foot print mq135 y yl100
    [12volts.sch, BH1750.sch, DHT22.sch, ModuloReles.sch, PCB-ESP32S.sch, alimentacion.sch, pines_sensor.sch]
2021-12-16 esp-32 actualizacion
    [12volts.sch, BH1750.sch, DHT22.sch, ModuloReles.sch, PCB-ESP32S.kicad_pcb, PCB-ESP32S.sch, PCB-biosistemas.kicad_pcb, PCB-biosistemas.sch]
2021-12-16 Actualización
    [BH1750.sch, DHT22.sch, ModuloReles.sch, PCB-ESP32S.sch, alimentacion.sch, charger_stepup-2021-12-16-07-30-41.sch, pines_sensor.sch]
2021-12-16 Actualización2
    [alimentacion.sch]
2021-12-18 Baterías-actualización
    [BH1750.sch, DHT22.sch, ModuloReles.sch, PCB-ESP32S.sch, alimentacion.sch, baterias.sch, charger_stepup-2021-12-17-18-29-46.sch, pines_sensor.sch]
2021-12-19 verificacion componentes
    [BH1750.sch, PCB-ESP32S.kicad_pcb, PCB-ESP32S.sch, alimentacion.sch, baterias.sch, charger_stepup-2021-11-30-07-37-55.sch, charger_stepup.kicad_pcb, charger_stepup.sch]
2021-12-19 LuzSens-actualización
    [BH1750.sch, PCB-ESP32S.sch, charger_stepup-2021-12-17-19-24-01.sch]
2022-01-12 Pines sensores
    [PCB-ESP32S.sch]
2022-01-12 Baterías
    [12volts.sch, BH1750.sch, DHT22.sch, ESP32-Footprints.kicad_pcb, ESP32-Footprints.sch, ModuloReles.sch, PCB-ESP32S.kicad_pcb, PCB-ESP32S.sch]
2022-01-14 PCB reles
    [ModuloReles.sch, PCB-ESP32S.kicad_pcb, PCB-ESP32S.sch]
2022-01-14 sensores y cto esp32
    [PCB-ESP32S.kicad_pcb, PCB-ESP32S.sch]
2022-01-14 PCBs ok
    [BH1750.sch, PCB-ESP32S.kicad_pcb, PCB-ESP32S.sch, alimentacion.sch]
2022-01-17 pcv v2
    [BH1750.sch, DHT22.sch, PCB-ESP32S.kicad_pcb, PCB-ESP32S.sch, alimentacion.sch]
2022-01-18 PCB reles - GND plano
    [PCB-ESP32S.kicad_pcb, PCB-ESP32S.sch, alimentacion.sch]
2022-01-18 mejoras pcb1
    [BH1750.sch, DHT22.sch, PCB-ESP32S.kicad_pcb, PCB-ESP32S.sch, alimentacion.sch, charger_stepup-2022-01-18-08-03-43.sch, pines_sensor.sch, pines_sensor2.sch]
2022-01-20 dos pcb finalizadas
    [ModuloReles.sch, PCB-ESP32S.kicad_pcb, PCB-ESP32S.sch, alimentacion.sch]
2022-01-20 archivos bom y gerber para manufactura
    [PCB-ESP32S-B_Cu.gbr, PCB-ESP32S-B_Mask.gbr, PCB-ESP32S-B_Paste.gbr, PCB-ESP32S-B_SilkS.gbr, PCB-ESP32S-Edge_Cuts.gbr, PCB-ESP32S-F_Cu.gbr, PCB-ESP32S-F_Mask.gbr, PCB-ESP32S-F_Paste.gbr]
2022-01-20 edicion true hole
    [BH1750.sch, DHT22.sch, PCB-ESP32S.kicad_pcb, PCB-ESP32S.sch, pines_sensor.sch, pines_sensor2.sch]
2022-01-20 PCB relés, te lo juro por Dieguito Maradona :''v
    [PCB-ESP32S.kicad_pcb, PCB-ESP32S.sch]
2022-01-20 archivos bom y gerber para manufactura - mod
    [PCB-ESP32S-B_Cu.gbr, PCB-ESP32S-B_Mask.gbr, PCB-ESP32S-B_Paste.gbr, PCB-ESP32S-B_SilkS.gbr, PCB-ESP32S-Edge_Cuts.gbr, PCB-ESP32S-F_Cu.gbr, PCB-ESP32S-F_Mask.gbr, PCB-ESP32S-F_Paste.gbr]
2022-01-25 imagenes_diseño en kicad
    [PCB-ESP32S.sch]
2022-01-30 pcb elaboradas
2022-02-07 pcb con elementos soldados
    [PCB-ESP32S-NPTH.drl, PCB-ESP32S-PTH.drl]
2022-02-07 pcb con elementos soldados2
